CascoLogix/arduino_teensy_mikrobus/Hardware/EDA/Rendered_Pics/Arduino_Teensy_mikroBUS2_9V.png

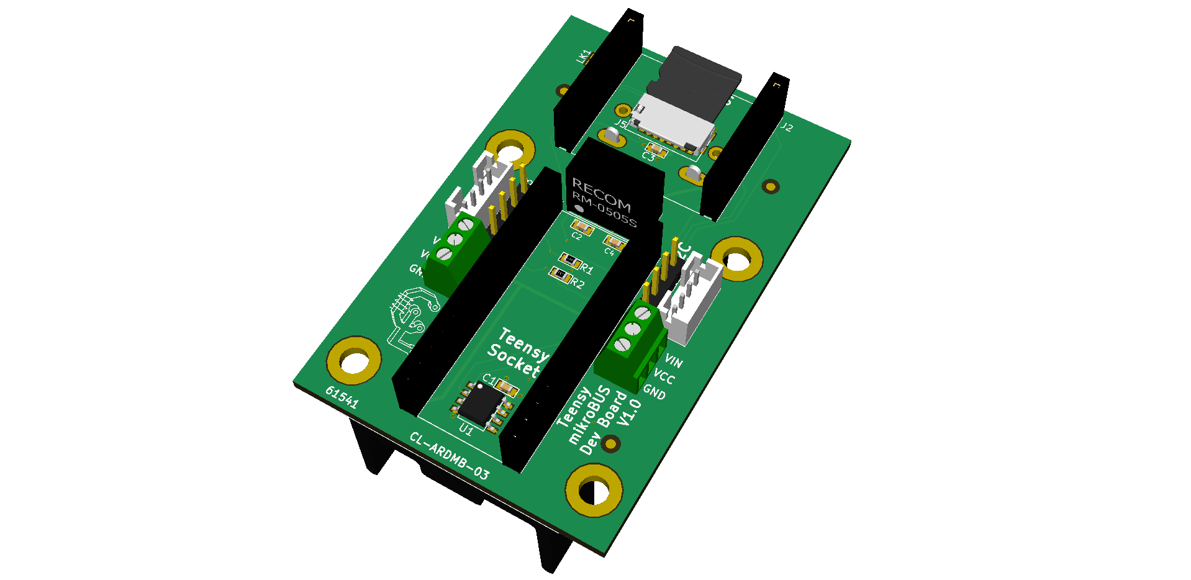
Hardware/EDA/Rendered_Pics/Arduino_Teensy_mikroBUS2_9V.png
