CascoLogix/arduino_teensy_mikrobus/Hardware/EDA/Rendered_Pics/Arduino_Teensy_mikroBUS10_2xAA.png

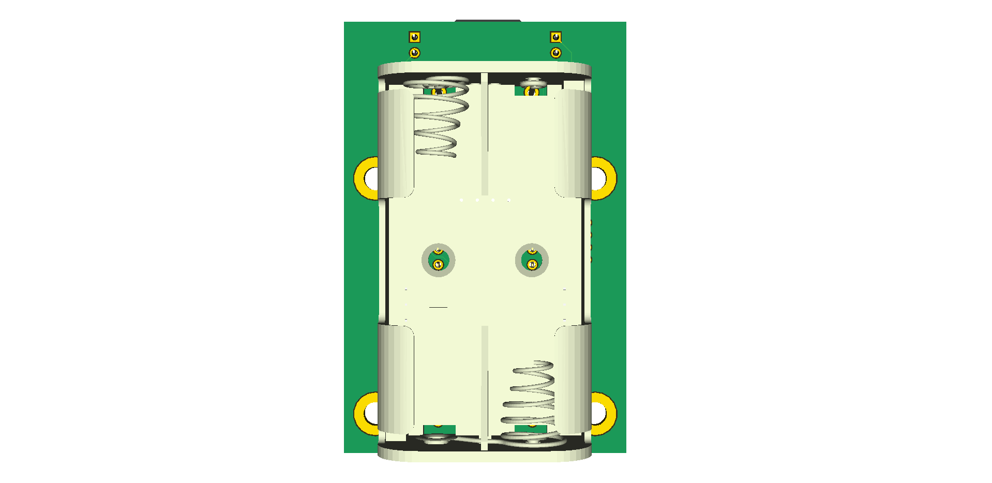
Hardware/EDA/Rendered_Pics/Arduino_Teensy_mikroBUS10_2xAA.png
