CascoLogix/arduino_teensy_mikrobus/Hardware/EDA/Drawing/Arduino_Teensy_mikroBUS.pdf

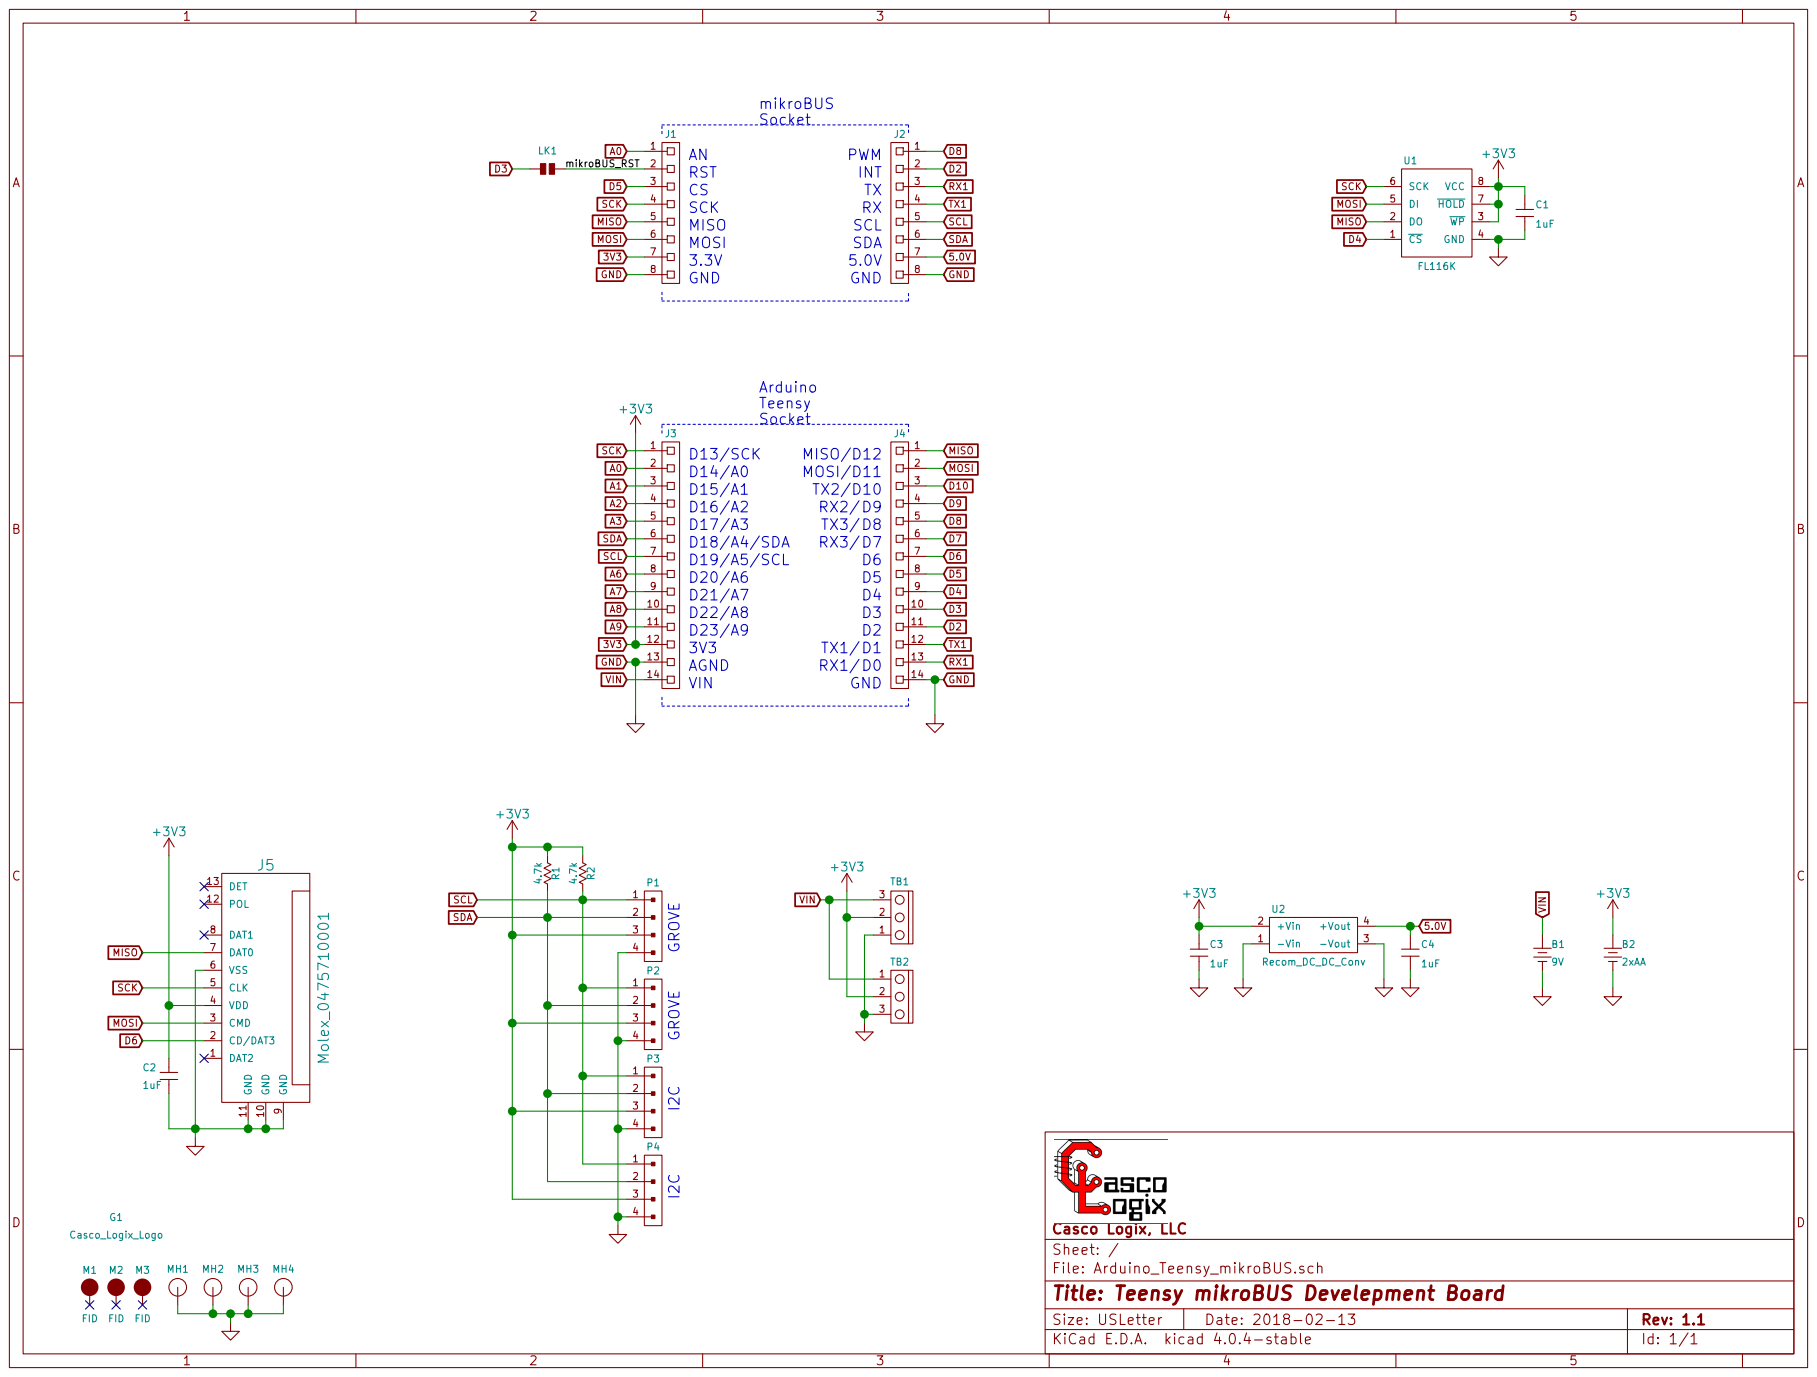
[picture p6: page 1]

9 GND 10 GND 11 POL 12 DET 13 J5 Molex_0475710001

File: Arduino_Teensy_mikroBUS.sch Sheet: / Casco Logix, LLC

Id: 1/1 Title: Teensy mikroBUS Develepment Board
