CascoLogix/arduino_teensy_mikrobus/Hardware/EDA/Arduino_Teensy_mikroBUS.kicad_pcb

## KiCad design Hardware/EDA/Arduino_Teensy_mikroBUS.kicad_pcb (2018-04-07)

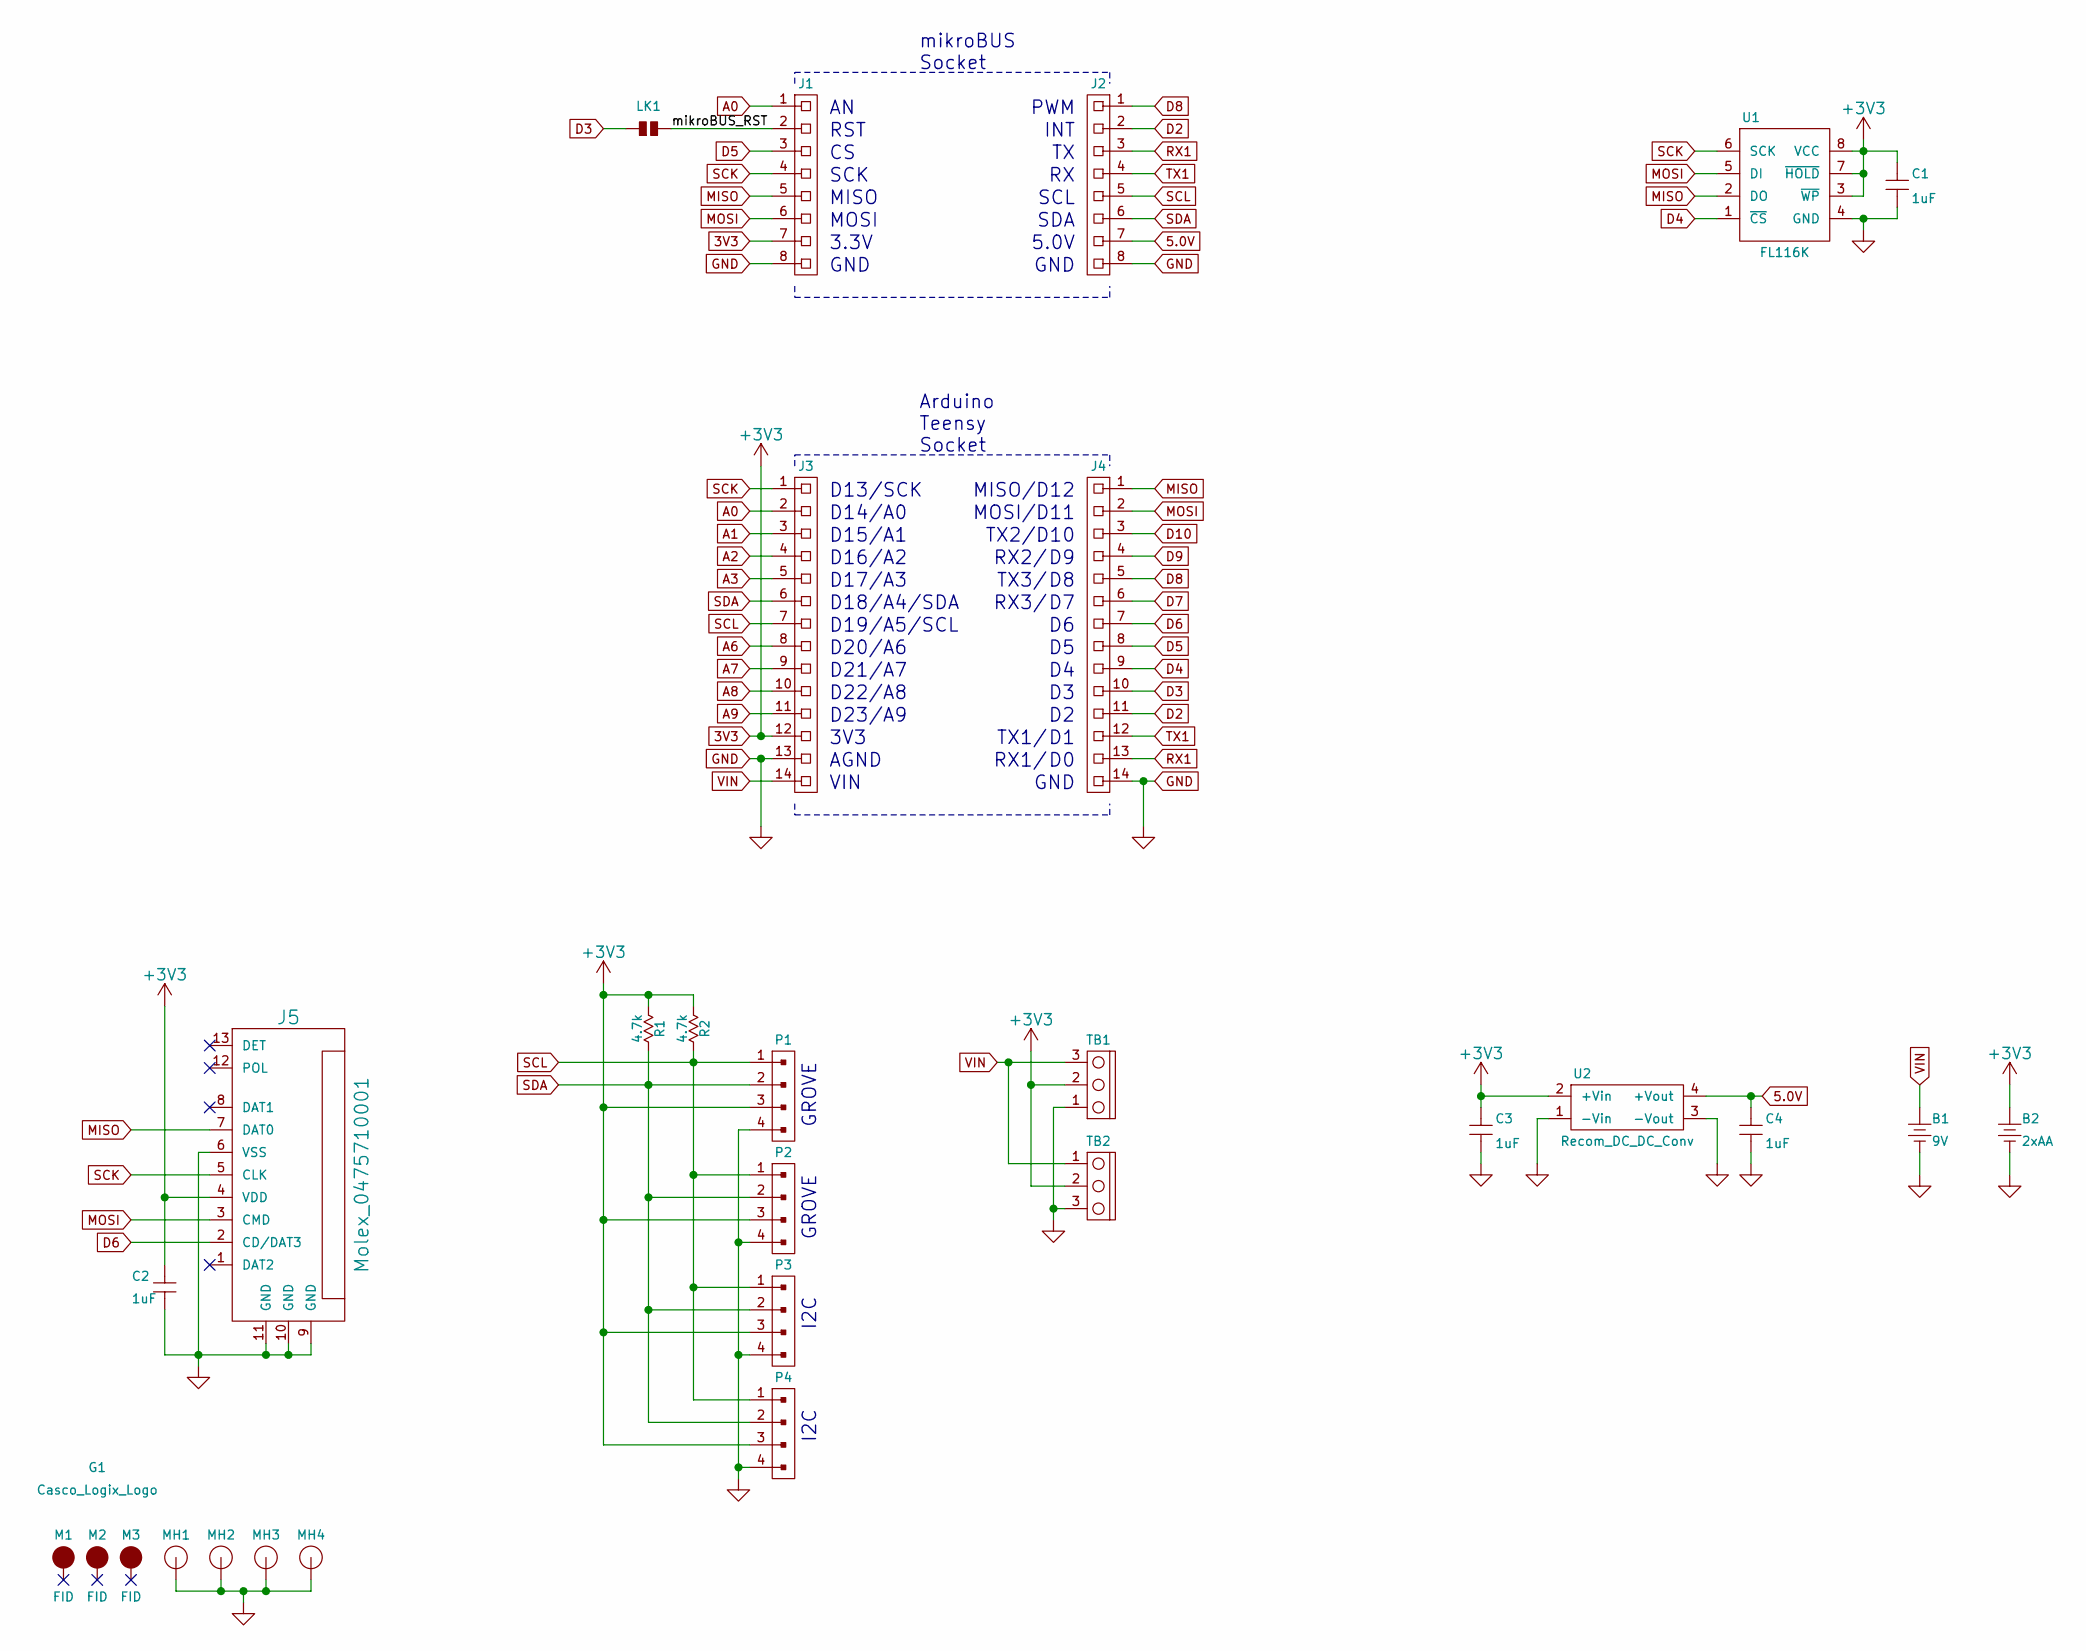
[picture p7: schematic Arduino_Teensy_mikroBUS.sch, Teensy mikroBUS Develepment Board]

Parts:
B1: 9V; BC9VPC
B2: 2xAA; Keystone_2462_2AA
C1, C2, C3, C4: 1uF; 0603
G1: Casco_Logix_Logo; Casco_Logix_Logo_7x7MM
J1, J2: HEADER_F_2.54MM_1R8P_ST_AU_PTH
J3, J4: HEADER_F_2.54MM_1R14P_ST_AU_PTH
J5: Molex_0475710001
LK1: SOLDER_LINK_NO
M1, M2, M3: FID; FIDUCIAL
MH1, MH2, MH3, MH4: MTG_HOLE; MH_#6
P1, P2, P3, P4: HEADER_M_2.54MM_1R4P_ST_AU_PTH
R1, R2: 4.7k; R0603
TB1, TB2: OSTVN_1x3; TB_100MIL_1R3P_PTH
U1: FL116K; SO-8
U2: Recom_DC_DC_Conv; Recom_ROE-3.305S

Connections:
3V3: B2.1 (+), C1.1, C2.1, C3.1, J1.7, J3.12, J5.4 (VDD), P1.3, P2.3, P3.3, P4.3, R1.1, R2.1, TB1.2, TB2.2, U1.3 (~WP), U1.7 (~HOLD), U1.8 (VCC), U2.2 (+Vin)
5.0V: C4.1, J2.7, U2.4 (+Vout)
A0: J1.1, J3.2
A1: J3.3
A2: J3.4
A3: J3.5
A6: J3.8
A7: J3.9
A8: J3.10
A9: J3.11
D2: J2.2, J4.11
D3: J4.10, LK1.1
D4: J4.9, U1.1 (~CS)
D5: J1.3, J4.8
D6: J4.7, J5.2 (CD/DAT3)
D7: J4.6
D8: J2.1, J4.5
D9: J4.4
D10: J4.3
GND: B1.2 (-), B2.2 (-), C1.2, C2.2, C3.2, C4.2, J1.8, J2.8, J3.13, J4.14, J5.6 (VSS), J5.9 (GND), J5.10 (GND), J5.11 (GND), MH1.~, MH2.~, MH3.~, MH4.~, P1.4, P2.4, P3.4, P4.4, TB1.1, TB2.3, U1.4 (GND), U2.1 (-Vin), U2.3 (-Vout)
MISO: J1.5, J4.1, J5.7 (DAT0), U1.2 (DO)
MOSI: J1.6, J4.2, J5.3 (CMD), U1.5 (DI)
RX1: J2.3, J4.13
SCK: J1.4, J3.1, J5.5 (CLK), U1.6 (SCK)
SCL: J2.5, J3.7, P1.1, P2.1, P3.1, P4.1, R2.2
SDA: J2.6, J3.6, P1.2, P2.2, P3.2, P4.2, R1.2
TX1: J2.4, J4.12
VIN: B1.1 (+), J3.14, TB1.3, TB2.1
mikroBUS_RST: J1.2, LK1.2

Notes on the sheet:
mikroBUS Socket
Arduino Teensy Socket
RST
SCK
MISO
MOSI
3.3V
GND
PWM
INT
SCL
SDA
5.0V
D10
/A0
3V3
AGND
VIN
/A4/SDA
/A3
GROVE
I2C
MOSI/D11
MISO/D12
D13/SCK
D16
D17
D23
D22
D21
D20
D19
D18
D15
D14
/A2
/A1
/A5/SCL
/A9
/A8
/A7
/A6
RX3/
TX3/
RX2/
TX2/
RX1/
TX1/

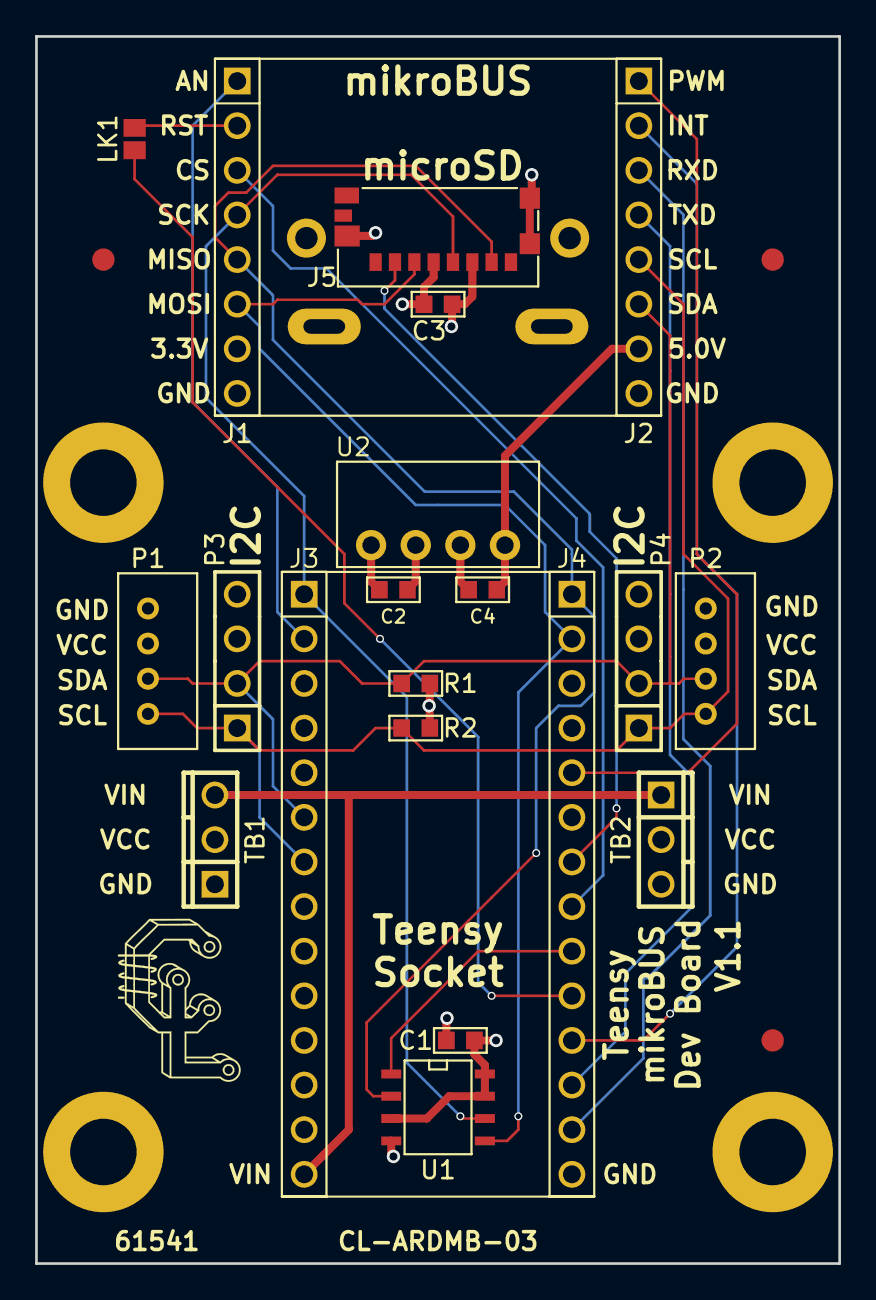
[picture p8: board Arduino_Teensy_mikroBUS.kicad_pcb from above]

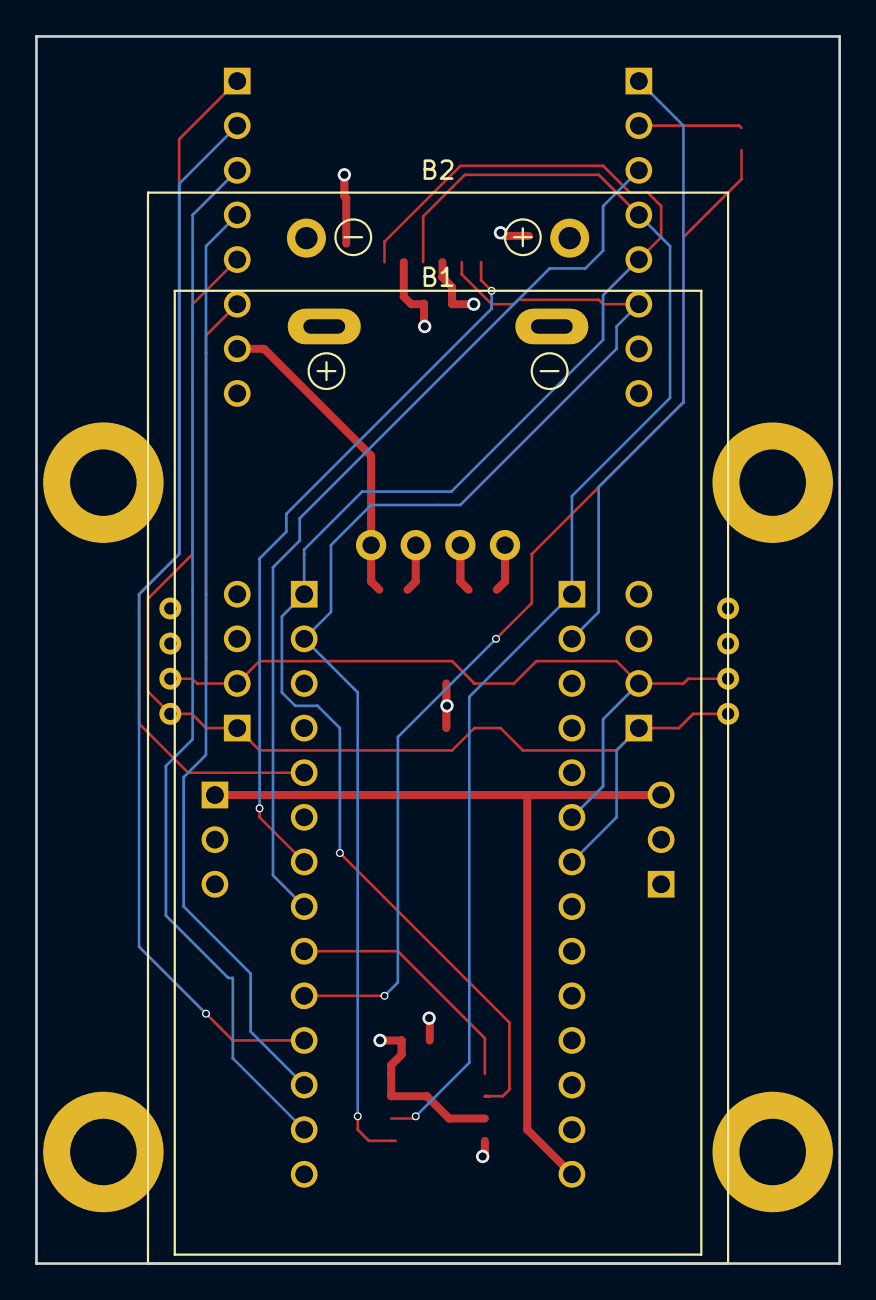
[picture p9: board Arduino_Teensy_mikroBUS.kicad_pcb from below]

Board: 4 copper layers, 45.7 x 69.8 mm, 30 parts (2 on the bottom side), 19 nets.
