CascoLogix/arduino_teensy_mikrobus/(threads)

Thread 1 (2018-03-31):

3V Battery Holder Footprint Pins Swapped

CascoLogix, 2018-03-31:
3V battery holder footprint has pins swapped so polarity is reversed. This should be corrected in the Casco Logix KiCAD component library, then update the layout.

CascoLogix, 2018-04-07:
Resolved error in KiCAD Library here:
[https://github.com/CascoLogix/KiCAD_Libraries/commit/263f8f1407974923df24015b3ebbb44121946b9c](url)

Issue resolution is pending layout corrections to PCB.

CascoLogix, 2018-04-07:
Layout corrections completed:
https://github.com/CascoLogix/arduino_teensy_mikrobus/commit/e1bc0133586a9bf74316edb4dc5f81ee5b778c6f

Closed 2018-04-07.

Thread 2 (2018-03-31):

9V Battery Holder Footprint Pins Swapped

CascoLogix, 2018-03-31:
9V battery holder footprint has pins swapped so polarity is reversed. This should be corrected in the Casco Logix KiCAD component library, then update the layout.

CascoLogix, 2018-04-07:
Resolved error in KiCAD Library here:
[https://github.com/CascoLogix/KiCAD_Libraries/commit/263f8f1407974923df24015b3ebbb44121946b9c](url)

Issue resolution is pending layout corrections to PCB.

CascoLogix, 2018-04-07:
Layout corrections completed:
https://github.com/CascoLogix/arduino_teensy_mikrobus/commit/e1bc0133586a9bf74316edb4dc5f81ee5b778c6f

Closed 2018-04-07.
