CascoLogix/arduino_teensy_mikrobus/(commit log)

2017-12-28 Initial commit.
    [Arduino_Teensy_mikroBUS.kicad_pcb, Arduino_Teensy_mikroBUS.sch]
2017-12-29 Updated schematic, netlist and read in netlist to PCB file. Added pinouts for Teensy.
    [Arduino_Teensy_mikroBUS.kicad_pcb, Arduino_Teensy_mikroBUS.sch]
2017-12-29 Completed PCB layout, added PCB render image, generated gerbers and schematic.
    [Arduino_Teensy_mikroBUS.kicad_pcb, Arduino_Teensy_mikroBUS.sch]
2018-01-06 Changed PCB outline/size to accomodate mounting holes, but still fit in enclosure. Regenerated Gerbers and PCB render images.
    [Arduino_Teensy_mikroBUS.kicad_pcb]
2018-01-14 Adjustment of mounting hole locations was missed. Corrected and updated gerbers and dimensions.
    [Arduino_Teensy_mikroBUS.kicad_pcb]
2018-02-17 Added comments to PCB file to indicate updates needed.
    [Arduino_Teensy_mikroBUS.kicad_pcb, Arduino_Teensy_mikroBUS.sch]
2018-02-17 Final changes prior to gerber verification.
    [Arduino_Teensy_mikroBUS.kicad_pcb, Arduino_Teensy_mikroBUS.sch]
2018-04-07 Moved traces near MH2 to clean up layout. Regenerated Gerbers - need to be verified. Updated date in PCB title block. Regenerated PDF schematic.
    [Arduino_Teensy_mikroBUS.kicad_pcb]
2018-04-07 Verified gerbers for release.
2018-04-07 Removed change comments from PCB file.
    [Arduino_Teensy_mikroBUS.kicad_pcb]
